hotchk155/arpie-cv-tab/docs/Image1.bmp

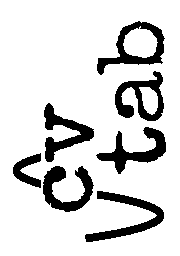
docs/Image1.bmp
