hotchk155/arpie-cv-tab/hardware/arpie_cv_tab.brd

## EAGLE design hardware/arpie_cv_tab.brd (2019-01-28)

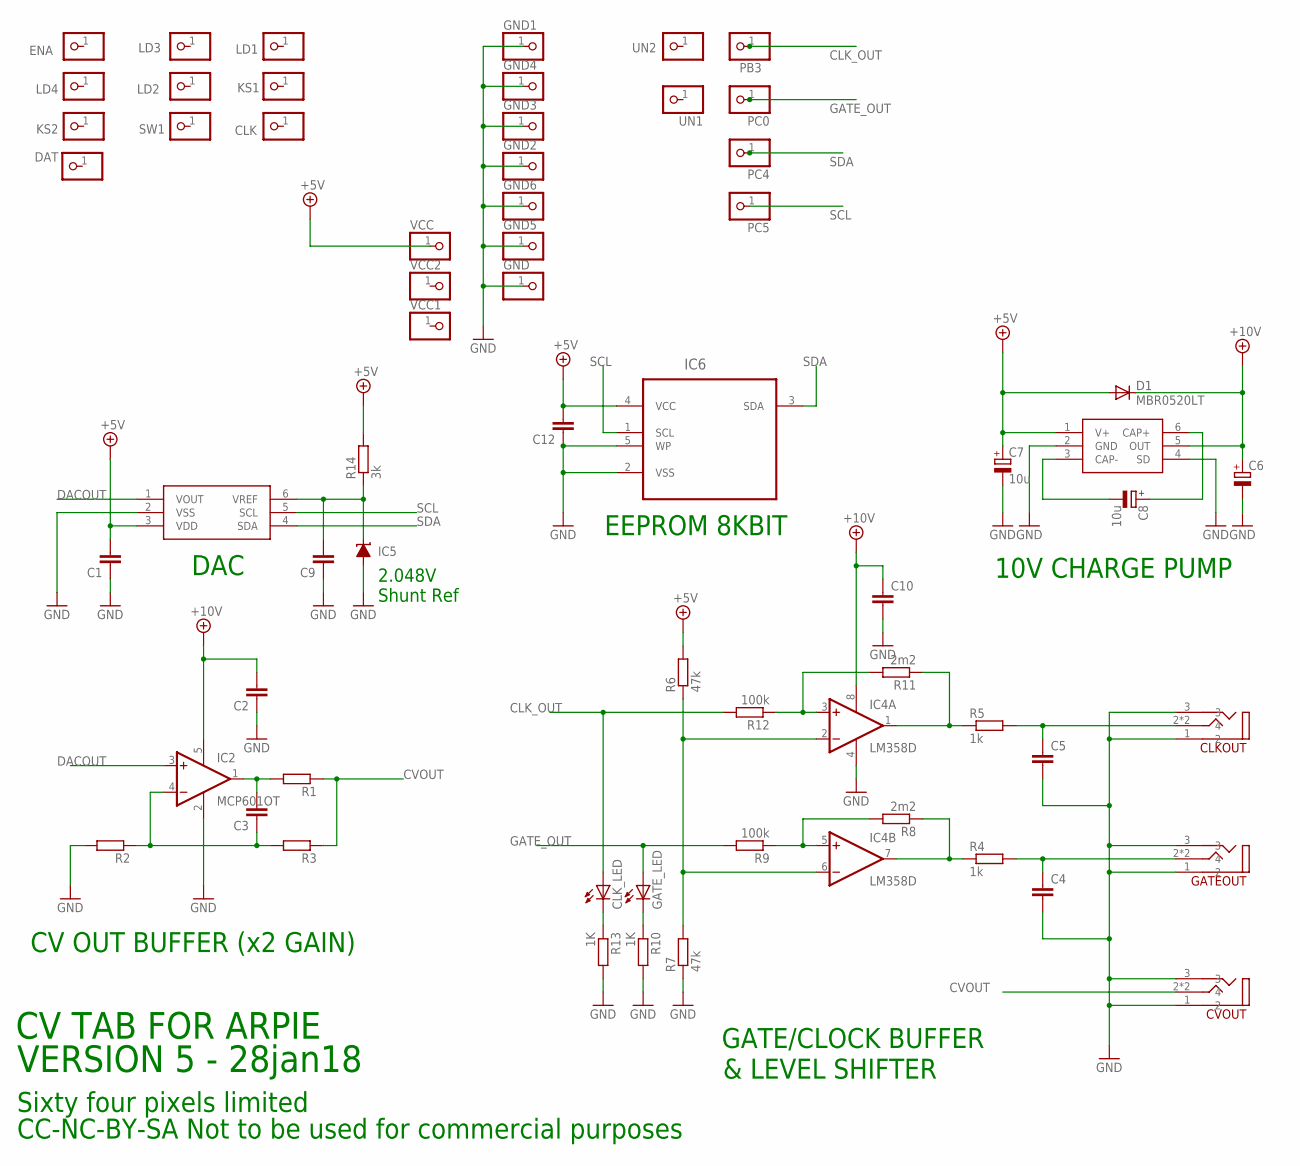
[picture p3: schematic arpie_cv_tab.sch]

Parts:
C1, C2, C3, C4, C5, C9, C10, C12: C-EUC0805; C0805
C6: CPOL-EUSMCA; SMC_A
C7, C8: 10u; SMC_A
CLK: PINHD-1X1; 1X01
CLKOUT: 3_5MM_PTH_MICRO
CLK_LED: LEDCHIP-LED0805; CHIP-LED0805
CVOUT: 3_5MM_PTH_MICRO
D1: MBR0520LT; SOD123
DAT: PINHD-1X1; 1X01
ENA: PINHD-1X1; 1X01
GATEOUT: 3_5MM_PTH_MICRO
GATE_LED: LEDCHIP-LED0805; CHIP-LED0805
GND, GND1, GND2, GND3, GND4, GND5, GND6: PINHD-1X1; 1X01
IC1: MCP4726; SOT23-6
IC2: MCP601OT; SOT23-5
IC3: LM27675M5_CHARGEPUMP; SOT23-6
IC4: LM358D; SO08
IC5: LM4041A12DBZ; DBZ_R-PDSO-G3
IC6: 24LC_16BT-I/OT; SOT95P290X145-5N
KS1, KS2: PINHD-1X1; 1X01
LD1, LD2, LD3, LD4: PINHD-1X1; 1X01
PB3: PINHD-1X1; 1X01
PC0, PC4, PC5: PINHD-1X1; 1X01
R1, R2, R3: R-EU_R0805; R0805
R4, R5: 1k; R0805
R6, R7: 47k; R0805
R8, R11: 2m2; R0805
R9, R12: 100k; R0805
R10, R13: 1K; R0805
R14: 3k; R0805
SW1: PINHD-1X1; 1X01
UN1, UN2: PINHD-1X1; 1X01
VCC, VCC1, VCC2: PINHD-1X1; 1X01

Connections:
+5V: C1.2, C7.+, C12.2, D1.A, IC1.3 (VDD), IC3.1 (V+), IC6.4 (VCC), R6.2, R14.2, VCC.1
+10V: C2.2, C6.+, C10.1, D1.C, IC2.5 (V+), IC3.5 (OUT), IC4.8 (V+)
CLK_OUT: CLK_LED.A, PB3.1, R12.2
CVOUT: CVOUT.2 (4), CVOUT.2A (4), R1.1, R3.1
DACOUT: IC1.1 (VOUT), IC2.3 (+IN)
GATE_OUT: GATE_LED.A, PC0.1, R9.2
GND: C1.1, C2.1, C4.2, C5.2, C6.-, C7.-, C9.1, C10.2, C12.1, CLKOUT.1 (2), CLKOUT.3, CVOUT.1 (2), CVOUT.3, GATEOUT.1 (2), GATEOUT.3, GND.1, GND1.1, GND2.1, GND3.1, GND4.1, GND5.1, GND6.1, IC1.2 (VSS), IC2.2 (V-), IC3.2 (GND), IC3.4 (SD), IC4.4 (V-), IC5.2 (A), IC6.2 (VSS), IC6.5 (WP), R2.2, R7.1, R10.2, R13.2
unnamed: IC4.2 (-IN), IC4.6 (-IN), R6.1, R7.2
unnamed: CLK_LED.C, R13.1
unnamed: GATE_LED.C, R10.1
unnamed: IC4.3 (+IN), R11.2, R12.1
unnamed: IC4.5 (+IN), R8.2, R9.1
unnamed: C9.2, IC1.6 (VREF), IC5.1 (C), R14.1
unnamed: IC4.1 (OUT), R5.1, R11.1
unnamed: C3.2, IC2.1 (OUT), R1.2
unnamed: IC4.7 (OUT), R4.1, R8.1
unnamed: C3.1, IC2.4 (-IN), R2.1, R3.2
unnamed: C5.1, CLKOUT.2 (4), CLKOUT.2A (4), R5.2
unnamed: C4.1, GATEOUT.2 (4), GATEOUT.2A (4), R4.2
unnamed: C8.+, IC3.6 (CAP+)
unnamed: C8.-, IC3.3 (CAP-)
SCL: IC1.5 (SCL), IC6.1 (SCL), PC5.1
SDA: IC1.4 (SDA), IC6.3 (SDA), PC4.1

Notes on the sheet:
10V CHARGE PUMP
DAC
CV OUT BUFFER (x2 GAIN)
GATE/CLOCK BUFFER
& LEVEL SHIFTER
CV TAB FOR ARPIE
VERSION 5 - 28jan18
Sixty four pixels limited
CC-NC-BY-SA Not to be used for commercial purposes
2.048V Shunt Ref
EEPROM 8KBIT

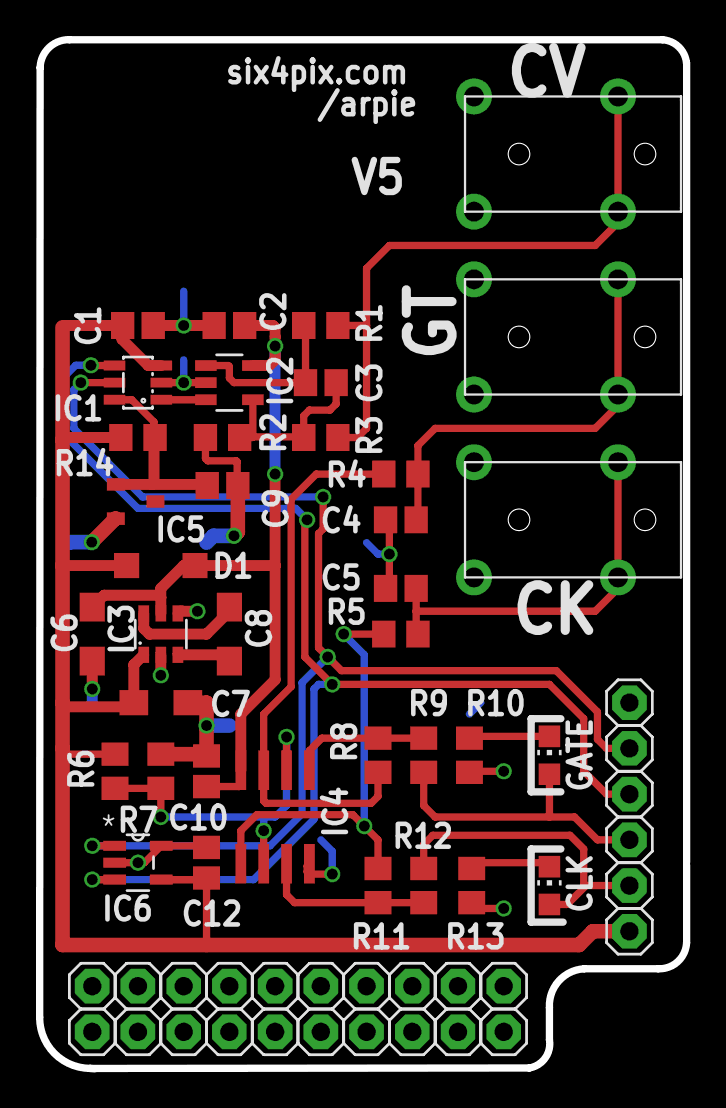
[picture p4: board hardware/arpie_cv_tab.brd from above]

Board: 2 copper layers, 35.9 x 57.2 mm, 63 parts (0 on the bottom side), 23 nets.
