hotchk155/arpie-cv-tab/stencil/arpie_cv_tab.brd

## EAGLE design stencil/arpie_cv_tab.brd (2019-02-28)

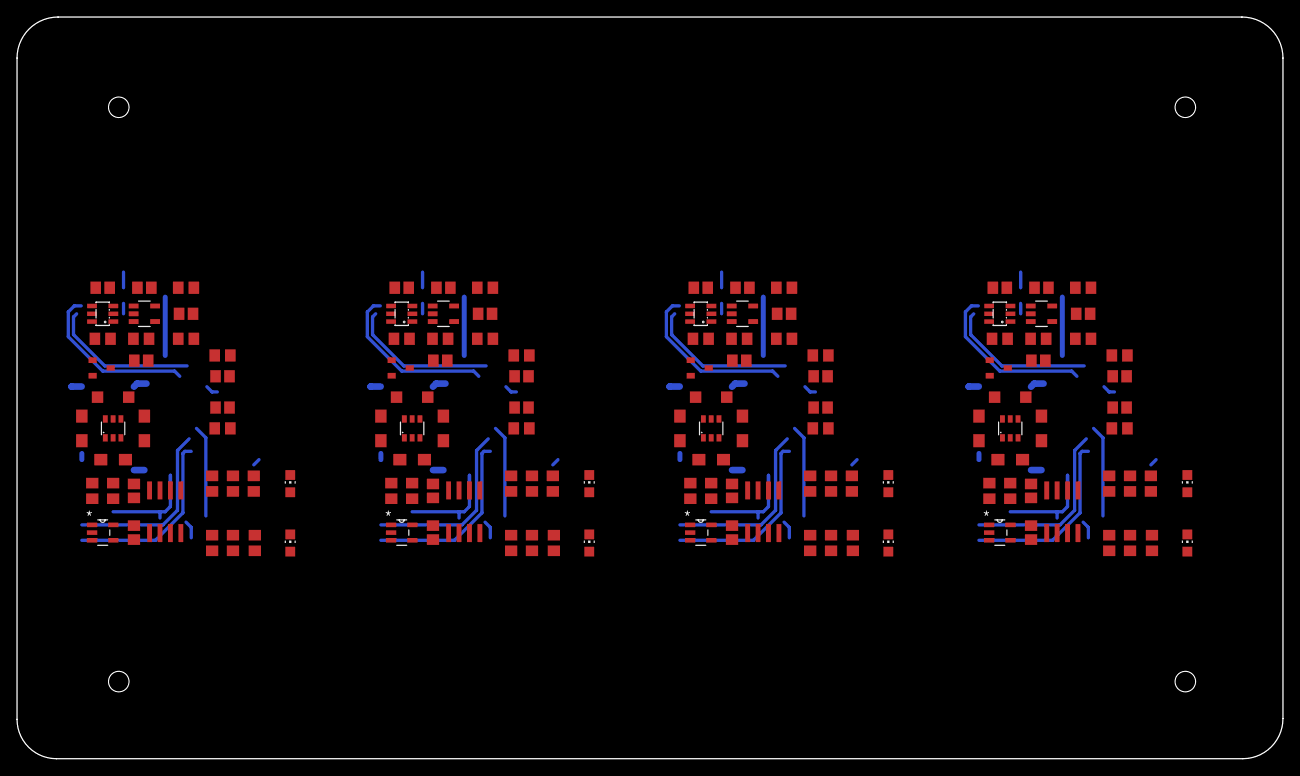
[picture p5: board stencil/arpie_cv_tab.brd from above]

Board: 2 copper layers, 154.3 x 90.4 mm, 140 parts (0 on the bottom side), 92 nets.

Parts:
C1, C2, C3, C4, C5, C9, C10, C11, C12, C13, C14, C15, C16, C20, C21, C22, C23, C24, C25, C26, C27, C31, C32, C33, C34, C35, C36, C37, C38, C42, C43, C44: C0805
C6, C18, C29, C40: SMC_A
C7, C8, C17, C19, C28, C30, C39, C41: 10u; SMC_A
CLK_LED, CLK_LED1, CLK_LED2, CLK_LED3: CHIP-LED0805
D1, D2, D3, D4: MBR0520LT; SOD123
E$4, E$5, E$6, E$7: STENCILPIN
GATE_LED, GATE_LED1, GATE_LED2, GATE_LED3: CHIP-LED0805
IC1, IC7, IC13, IC19: MCP4726; SOT23-6
IC2, IC8, IC14, IC20: MCP601OT; SOT23-5
IC3, IC9, IC15, IC21: LM27675M5_CHARGEPUMP; SOT23-6
IC4, IC10, IC16, IC22: LM358D; SO08
IC5, IC11, IC17, IC23: LM4041A12DBZ; DBZ_R-PDSO-G3
IC6, IC12, IC18, IC24: 24LC_16BT-I/OT; SOT95P290X145-5N
R1, R2, R3, R19, R20, R21, R33, R34, R35, R47, R48, R49: R0805
R4, R5, R17, R18, R31, R32, R45, R46: 1k; R0805
R6, R7, R22, R23, R36, R37, R50, R51: 47k; R0805
R8, R11, R26, R27, R40, R41, R54, R55: 2m2; R0805
R9, R12, R24, R25, R38, R39, R52, R53: 100k; R0805
R10, R13, R15, R16, R29, R30, R43, R44: 1K; R0805
R14, R28, R42, R56: 3k; R0805

Connections:
+5V: C1.2, C7.+, C12.2, D1.A, IC1.3, IC3.1, IC6.4, R6.2, R14.2
+5V1: C14.2, C19.+, C22.2, D2.A, IC7.3, IC9.1, IC12.4, R23.2, R28.2
+5V2: C25.2, C30.+, C33.2, D3.A, IC13.3, IC15.1, IC18.4, R37.2, R42.2
+5V3: C36.2, C41.+, C44.2, D4.A, IC19.3, IC21.1, IC24.4, R51.2, R56.2
+10V: C2.2, C6.+, C10.1, D1.C, IC2.5, IC3.5, IC4.8
+10V1: C15.2, C18.+, C20.1, D2.C, IC8.5, IC9.5, IC10.8
+10V2: C26.2, C29.+, C31.1, D3.C, IC14.5, IC15.5, IC16.8
+10V3: C37.2, C40.+, C42.1, D4.C, IC20.5, IC21.5, IC22.8
CLK_OUT: CLK_LED.A, R12.2
CLK_OUT1: CLK_LED1.A, R24.2
CLK_OUT2: CLK_LED2.A, R38.2
CLK_OUT3: CLK_LED3.A, R52.2
CVOUT: R1.1, R3.1
CVOUT1: R19.1, R20.1
CVOUT2: R33.1, R34.1
CVOUT3: R47.1, R48.1
DACOUT: IC1.1, IC2.3
DACOUT1: IC7.1, IC8.3
DACOUT2: IC13.1, IC14.3
DACOUT3: IC19.1, IC20.3
GATE_OUT: GATE_LED.A, R9.2
GATE_OUT1: GATE_LED1.A, R25.2
GATE_OUT2: GATE_LED2.A, R39.2
GATE_OUT3: GATE_LED3.A, R53.2
GND: C1.1, C2.1, C4.2, C5.2, C6.-, C7.-, C9.1, C10.2, C12.1, IC1.2, IC2.2, IC3.2, IC3.4, IC4.4, IC5.2, IC6.2, IC6.5, R2.2, R7.1, R10.2, R13.2
GND1: C11.2, C13.2, C14.1, C15.1, C18.-, C19.-, C20.2, C21.1, C22.1, IC7.2, IC8.2, IC9.2, IC9.4, IC10.4, IC11.2, IC12.2, IC12.5, R15.2, R16.2, R21.2, R22.1
GND2: C23.2, C24.2, C25.1, C26.1, C29.-, C30.-, C31.2, C32.1, C33.1, IC13.2, IC14.2, IC15.2, IC15.4, IC16.4, IC17.2, IC18.2, IC18.5, R29.2, R30.2, R35.2, R36.1
GND3: C34.2, C35.2, C36.1, C37.1, C40.-, C41.-, C42.2, C43.1, C44.1, IC19.2, IC20.2, IC21.2, IC21.4, IC22.4, IC23.2, IC24.2, IC24.5, R43.2, R44.2, R49.2, R50.1
unnamed: IC4.2, IC4.6, R6.1, R7.2
unnamed: CLK_LED.C, R13.1
unnamed: GATE_LED.C, R10.1
unnamed: IC4.3, R11.2, R12.1
unnamed: IC4.5, R8.2, R9.1
unnamed: C9.2, IC1.6, IC5.1, R14.1
unnamed: C11.1, R17.2
unnamed: C13.1, R18.2
unnamed: IC4.1, R5.1, R11.1
unnamed: IC10.7, R18.1, R26.1
unnamed: C3.2, IC2.1, R1.2
unnamed: IC4.7, R4.1, R8.1
unnamed: IC10.1, R17.1, R27.1
unnamed: C16.2, IC8.1, R19.2
unnamed: C3.1, IC2.4, R2.1, R3.2
unnamed: C16.1, IC8.4, R20.2, R21.1
unnamed: C17.+, IC9.6
unnamed: C17.-, IC9.3
unnamed: C5.1, R5.2
unnamed: C4.1, R4.2
unnamed: IC10.2, IC10.6, R22.2, R23.1
unnamed: CLK_LED1.C, R16.1
unnamed: GATE_LED1.C, R15.1
unnamed: IC10.3, R24.1, R27.2
unnamed: IC10.5, R25.1, R26.2
unnamed: C21.2, IC7.6, IC11.1, R28.1
unnamed: C23.1, R31.2
unnamed: C24.1, R32.2
unnamed: IC16.7, R32.1, R40.1
unnamed: IC16.1, R31.1, R41.1
unnamed: C27.2, IC14.1, R33.2
unnamed: C27.1, IC14.4, R34.2, R35.1
unnamed: C28.+, IC15.6
unnamed: C28.-, IC15.3
unnamed: IC16.2, IC16.6, R36.2, R37.1
unnamed: CLK_LED2.C, R30.1
unnamed: GATE_LED2.C, R29.1
unnamed: C8.+, IC3.6
unnamed: C8.-, IC3.3
unnamed: IC16.3, R38.1, R41.2
unnamed: IC16.5, R39.1, R40.2
unnamed: C32.2, IC13.6, IC17.1, R42.1
unnamed: C34.1, R45.2
unnamed: C35.1, R46.2
unnamed: IC22.7, R46.1, R54.1
unnamed: IC22.1, R45.1, R55.1
unnamed: C38.2, IC20.1, R47.2
unnamed: C38.1, IC20.4, R48.2, R49.1
unnamed: C39.+, IC21.6
unnamed: C39.-, IC21.3
unnamed: IC22.2, IC22.6, R50.2, R51.1
unnamed: CLK_LED3.C, R44.1
unnamed: GATE_LED3.C, R43.1
unnamed: IC22.3, R52.1, R55.2
unnamed: IC22.5, R53.1, R54.2
unnamed: C43.2, IC19.6, IC23.1, R56.1
SCL: IC1.5, IC6.1
SCL1: IC7.5, IC12.1
SCL2: IC13.5, IC18.1
SCL3: IC19.5, IC24.1
SDA: IC1.4, IC6.3
SDA1: IC7.4, IC12.3
SDA2: IC13.4, IC18.3
SDA3: IC19.4, IC24.3
