hotchk155/arpie-cv-tab/cvtab-test-rig/cvtab.xlsx

Sheet: A_BEFORE
MIDI | Expected | CVA | CVB | CVC | CVD | ErrA | ErrB | ErrC | ErrD | millivolts
36 | 1000 | 990 | 1004 | 996 | 1004 | -10 | 4 | -4 | 4
37 | 1083 | 1073 | 1085 | 1077 | 1084 | -10 | 2 | -6 | 1
38 | 1167 | 1158 | 1168 | 1160 | 1167 | -9 | 1 | -7 | 0
39 | 1250 | 1240 | 1253 | 1244 | 1250 | -10 | 3 | -6 | 0
40 | 1333 | 1322 | 1336 | 1326 | 1331 | -11 | 3 | -7 | -2
41 | 1417 | 1406 | 1418 | 1408 | 1412 | -11 | 1 | -9 | -5
42 | 1500 | 1489 | 1503 | 1494 | 1495 | -11 | 3 | -6 | -5
43 | 1583 | 1570 | 1586 | 1577 | 1578 | -13 | 3 | -6 | -5
44 | 1667 | 1654 | 1669 | 1660 | 1660 | -13 | 2 | -7 | -7
45 | 1750 | 1737 | 1753 | 1745 | 1744 | -13 | 3 | -5 | -6
46 | 1833 | 1818 | 1835 | 1828 | 1827 | -15 | 2 | -5 | -6
47 | 1917 | 1903 | 1920 | 1911 | 1909 | -14 | 3 | -6 | -8
48 | 2000 | 1989 | 2008 | 1996 | 1998 | -11 | 8 | -4 | -2
49 | 2083 | 2072 | 2091 | 2080 | 2082 | -11 | 8 | -3 | -1
50 | 2167 | 2157 | 2173 | 2162 | 2165 | -10 | 6 | -5 | -2
51 | 2250 | 2240 | 2258 | 2246 | 2251 | -10 | 8 | -4 | 1
52 | 2333 | 2321 | 2341 | 2329 | 2334 | -12 | 8 | -4 | 1
53 | 2417 | 2406 | 2424 | 2410 | 2417 | -11 | 7 | -7 | 0
54 | 2500 | 2489 | 2509 | 2495 | 2500 | -11 | 9 | -5 | 0
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
