hotchk155/arpie-cv-tab/(commit log)

2015-05-29 pcb ready
    [arpie_cv_tab.brd]
2018-11-17 v2 board
    [arpie_cv_tab.brd, arpie_cv_tab.sch]
2018-12-02 v3 board
    add voltage reference
    [arpie_cv_tab.brd, arpie_cv_tab.sch]
2018-12-18 v5 added eeprom
    [arpie_cv_tab.brd, arpie_cv_tab.sch]
2019-01-11 change jack outline
    [arpie_cv_tab.brd, arpie_cv_tab.sch]
2019-01-26 add values to schematic
    [arpie_cv_tab.brd, arpie_cv_tab.sch]
2019-01-28 V5 - change type of 3.5mm socket
    [arpie_cv_tab.brd, arpie_cv_tab.sch]
2021-06-24 test rig updates
    [cvtab.xlsx]
